gilberto-coelho/Automated-Control-Unit-HPLC-AAS/STL-files/README.md

STF files for the electronic's case and servo/valve holder.
