gilberto-coelho/Automated-Control-Unit-HPLC-AAS/STL-files/Holder valve.stl

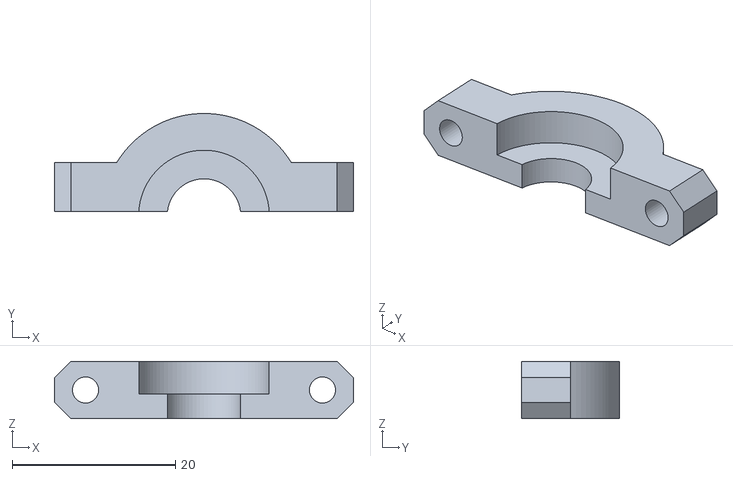
[picture p1: CAD file, 2026-10-16]
STL-files/Holder valve.stl
36.6 x 12.0 x 7.00
