gilberto-coelho/Automated-Control-Unit-HPLC-AAS/STL-files/Servo shaft.stl

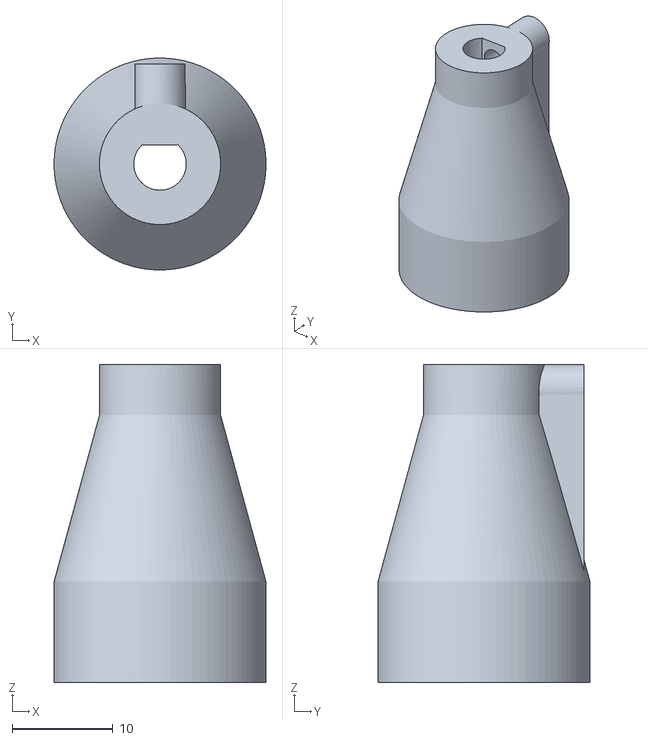
[picture p2: CAD file, 2026-10-16]
STL-files/Servo shaft.stl
21.0 x 21.0 x 31.5
