gilberto-coelho/Automated-Control-Unit-HPLC-AAS/STL-files/Holder 3-way valve.stl

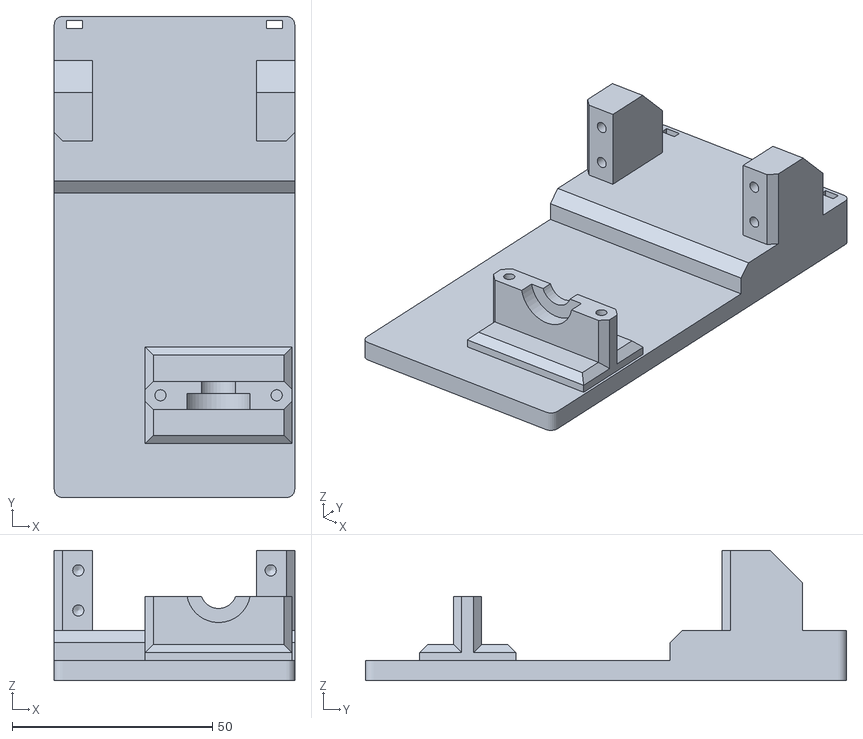
[picture p3: CAD file, 2026-10-16]
STL-files/Holder 3-way valve.stl
60.0 x 120.0 x 32.5
