gilberto-coelho/Automated-Control-Unit-HPLC-AAS/STL-files/Box 3-way valve.stl

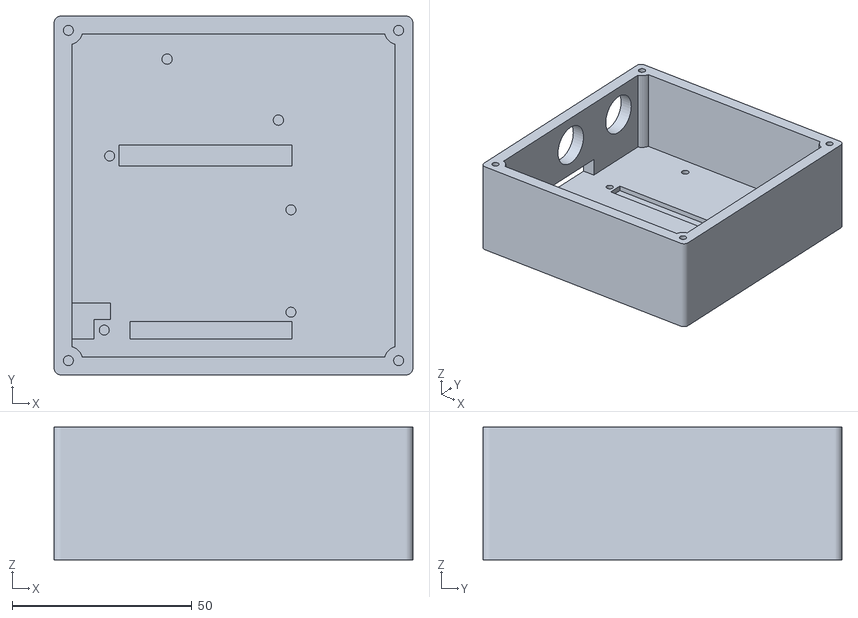
[picture p4: CAD file, 2026-10-16]
STL-files/Box 3-way valve.stl
100.0 x 100.0 x 37.0
