gilberto-coelho/Automated-Control-Unit-HPLC-AAS/STL-files/Lid Box 3-way valvej.stl

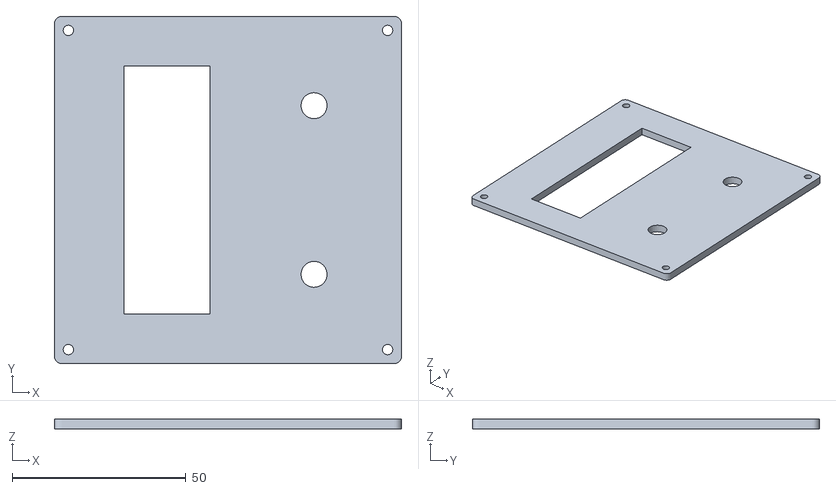
[picture p5: CAD file, 2026-10-16]
STL-files/Lid Box 3-way valvej.stl
100.0 x 100.0 x 3.00
